kiwih/hackster-programmer/hardware/unsw-cse-hackster-cc-by-sa-4.0/cse-hackster-feb-2026.pdf

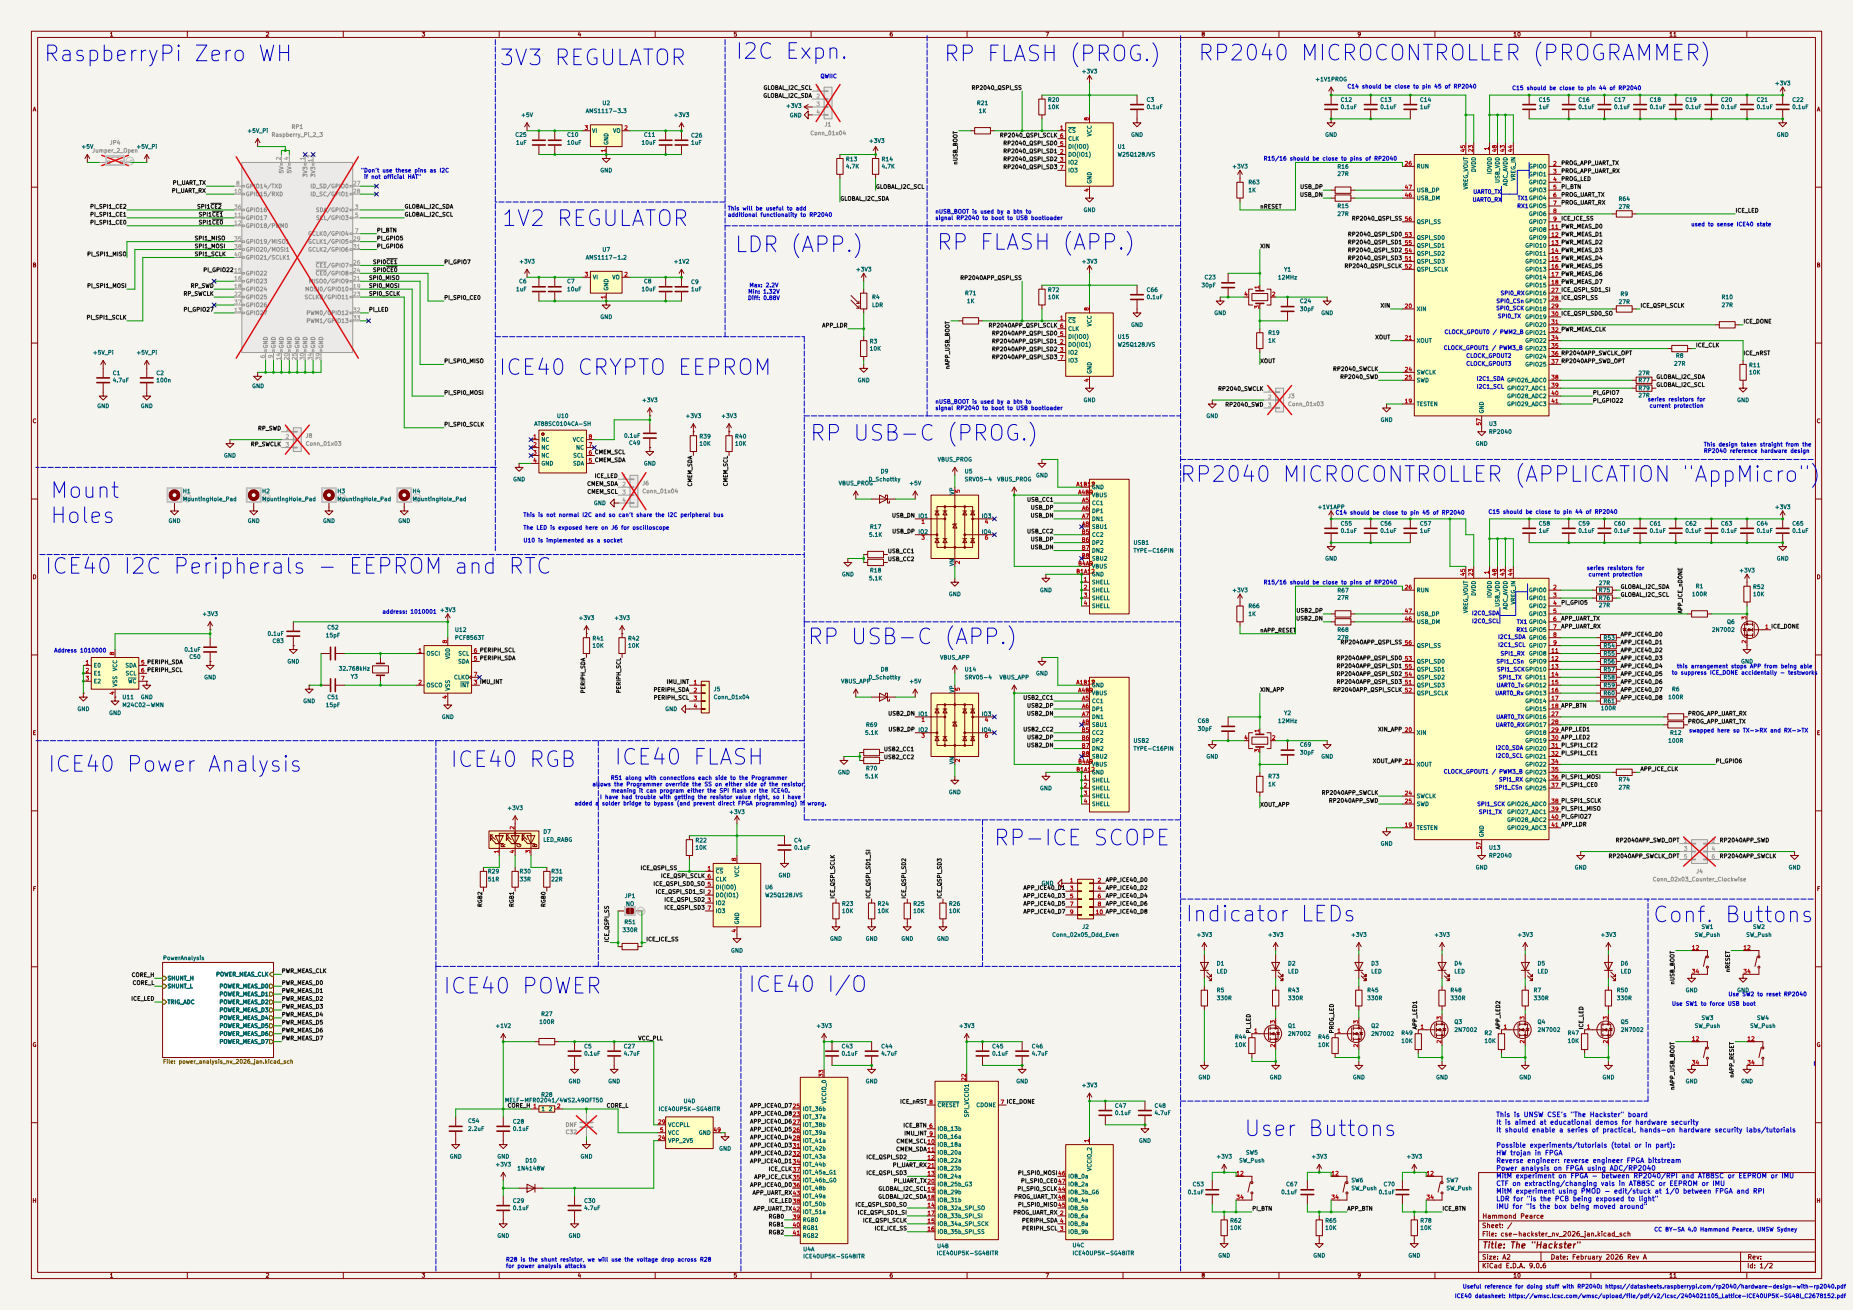
[picture p1: page 1]

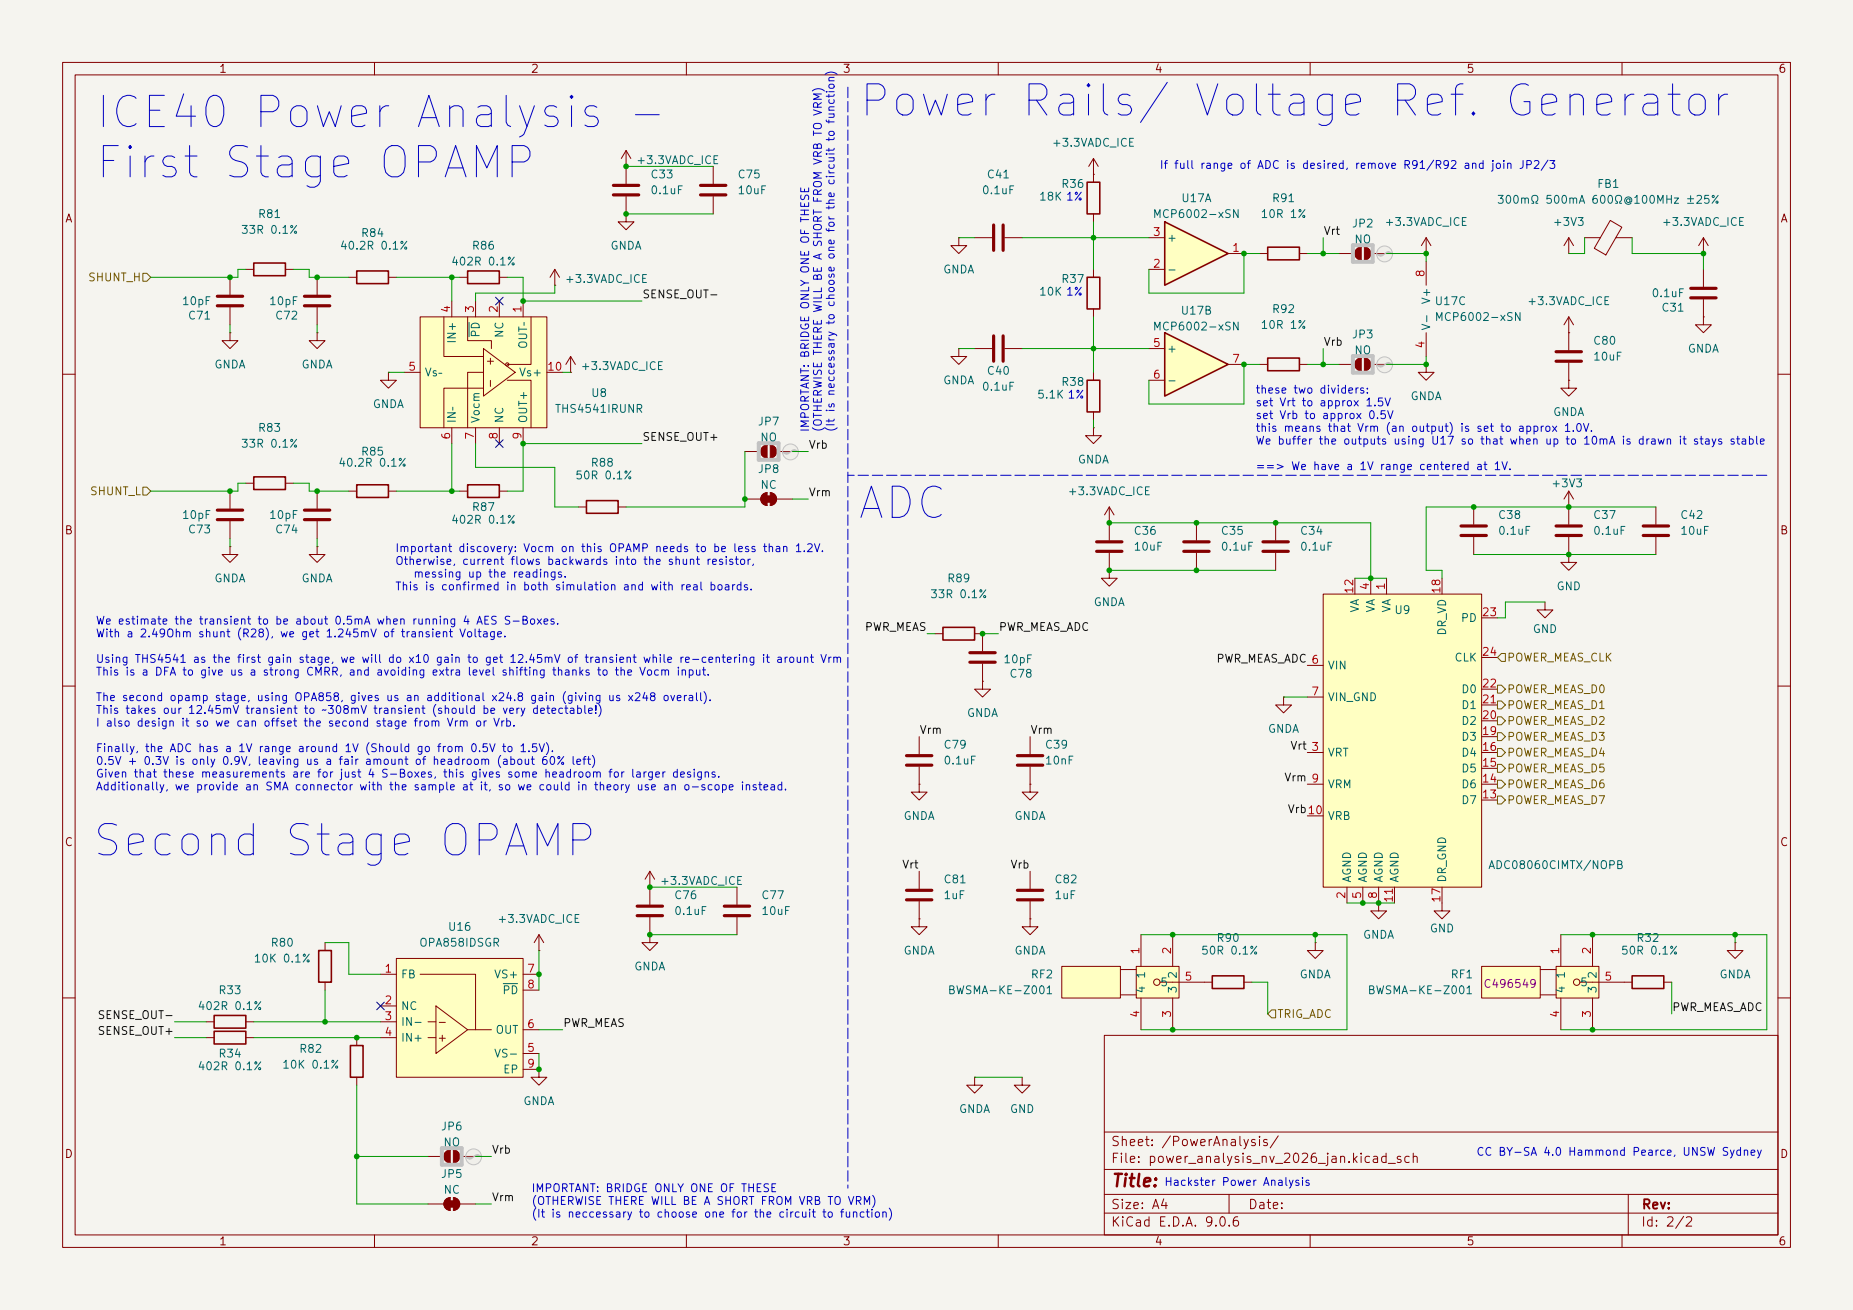
[picture p2: page 2]
