kiwih/hackster-programmer/hardware/unsw-cse-hackster-cc-by-sa-4.0/cse-hackster-gerber-preview-combined-layers-feb-2026.pdf

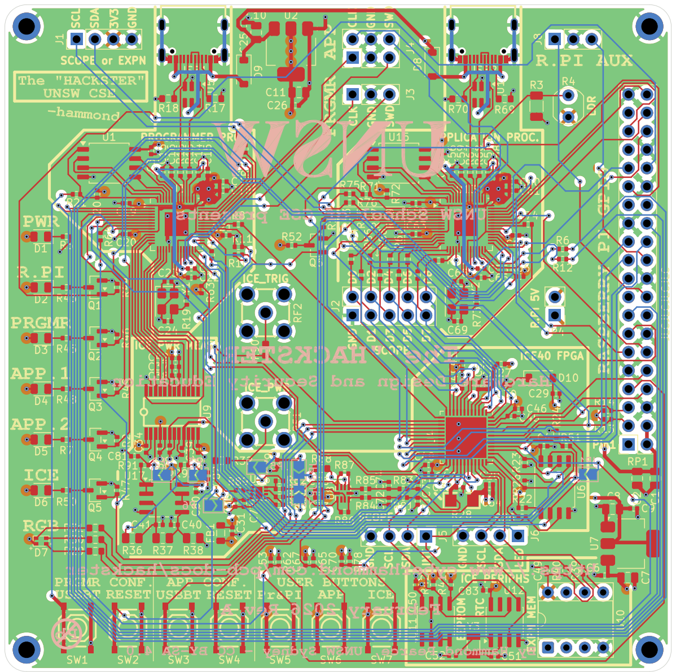
[picture p3: page 1]
