kiwih/hackster-programmer/hardware/unsw-cse-hackster-cc-by-sa-4.0/cse-hackster-gerber-preview-seperate-layers-feb-2026.pdf

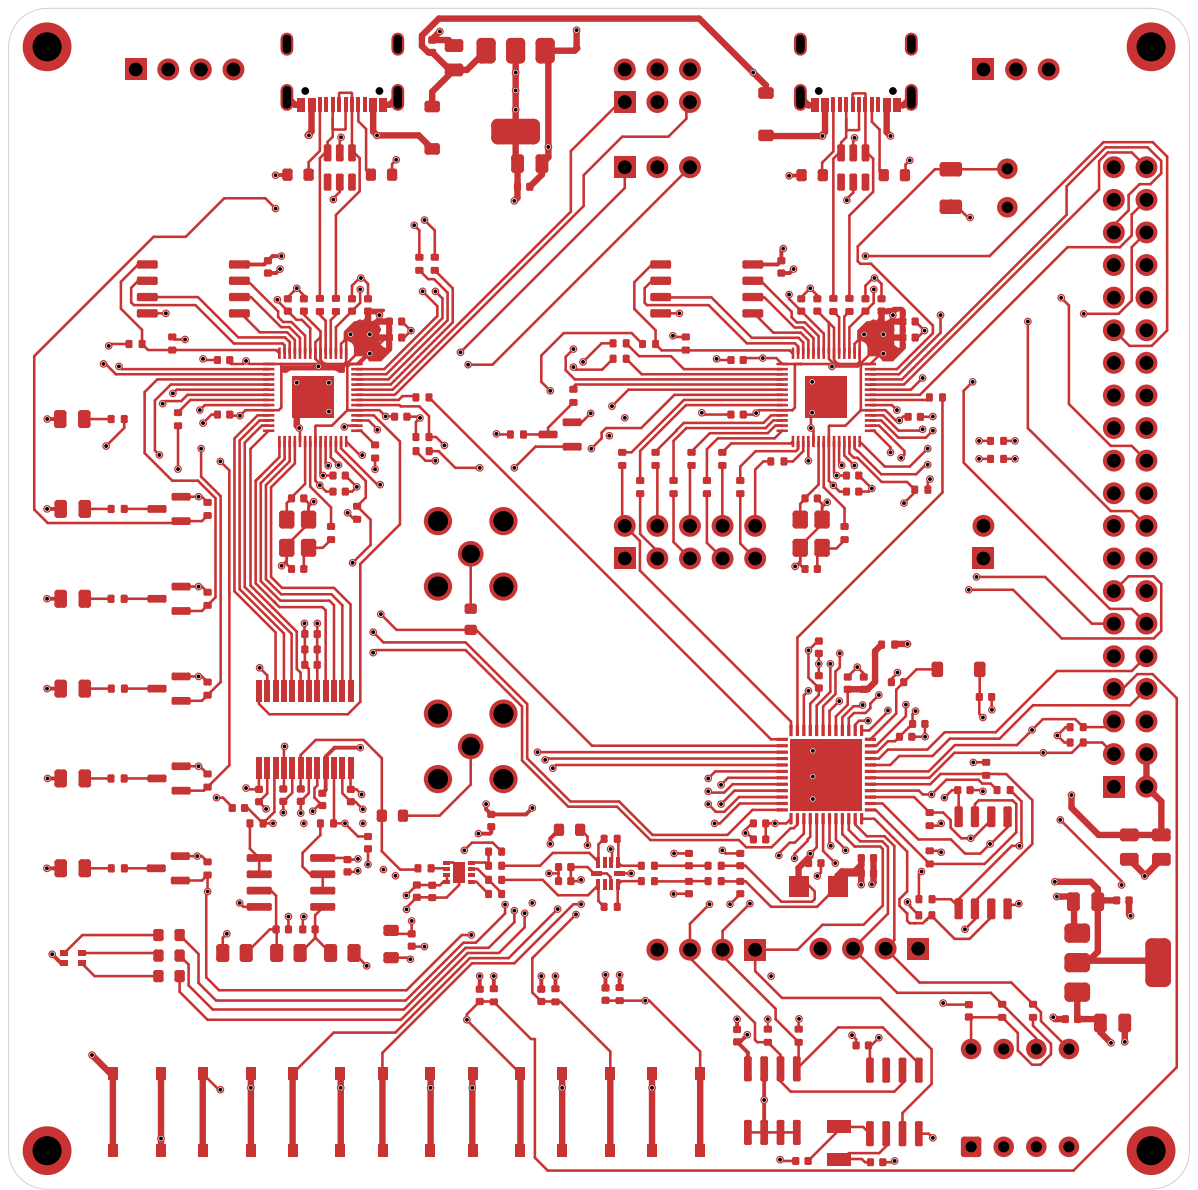
[picture p4: page 1]

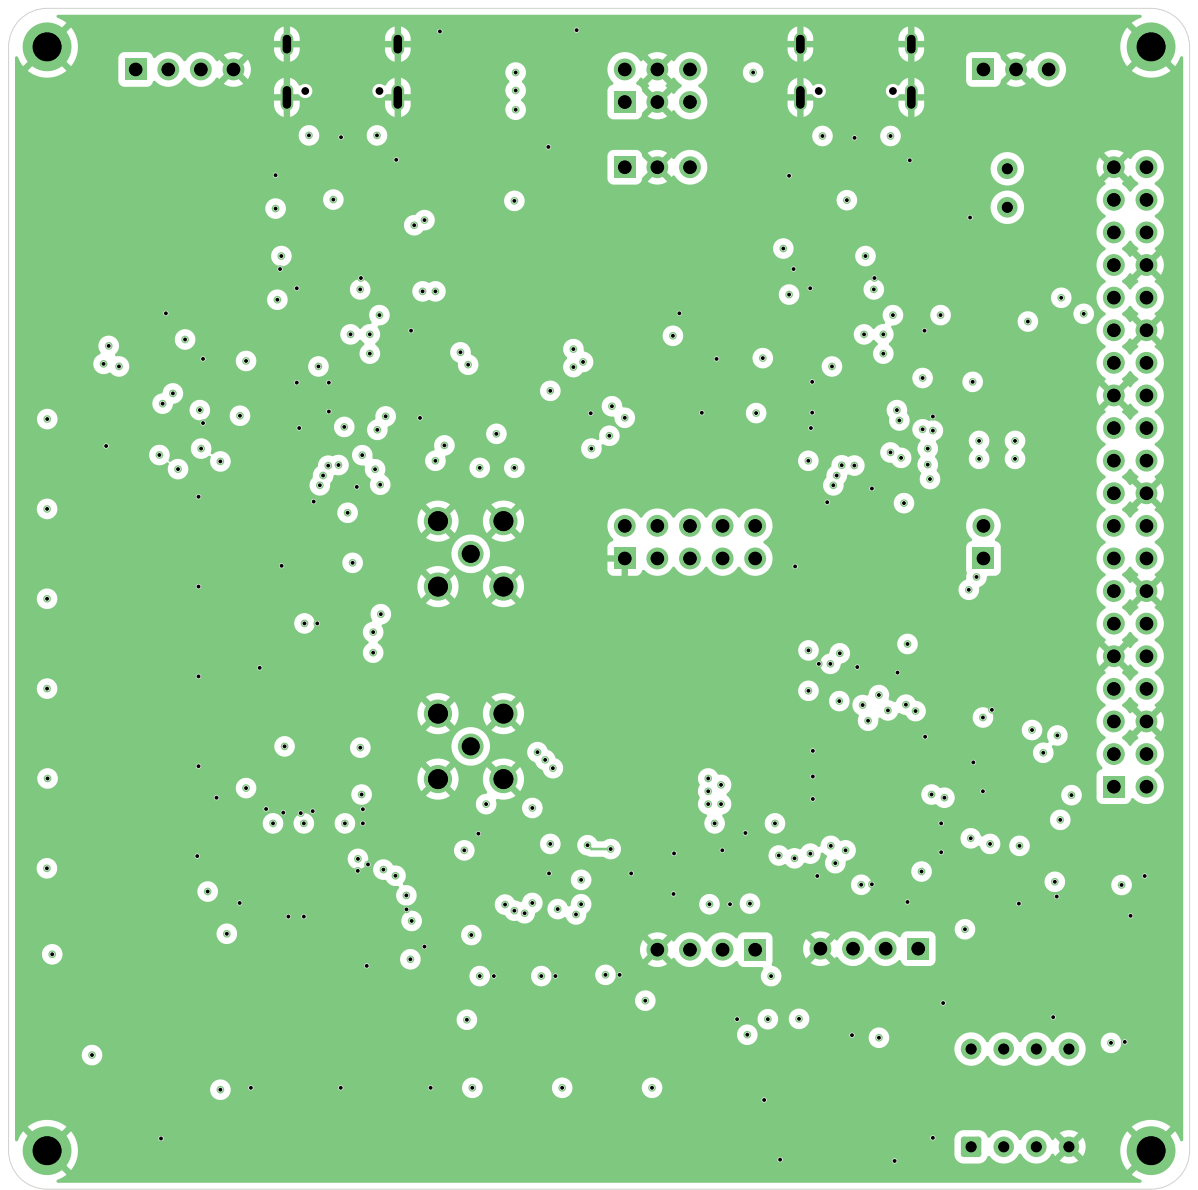
[picture p5: page 2]

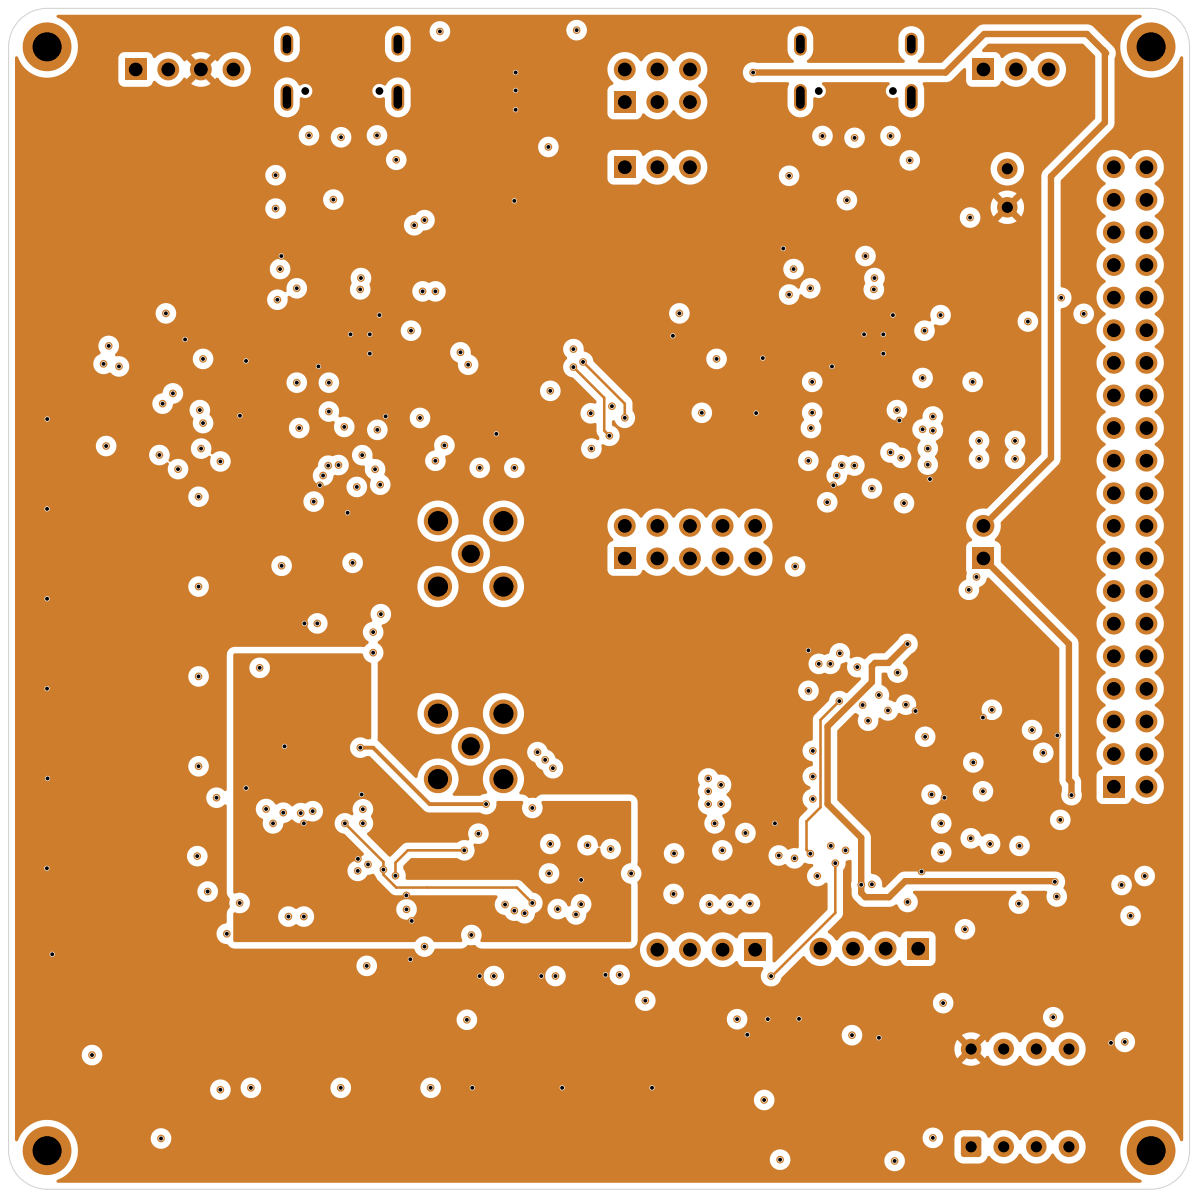
[picture p6: page 3]

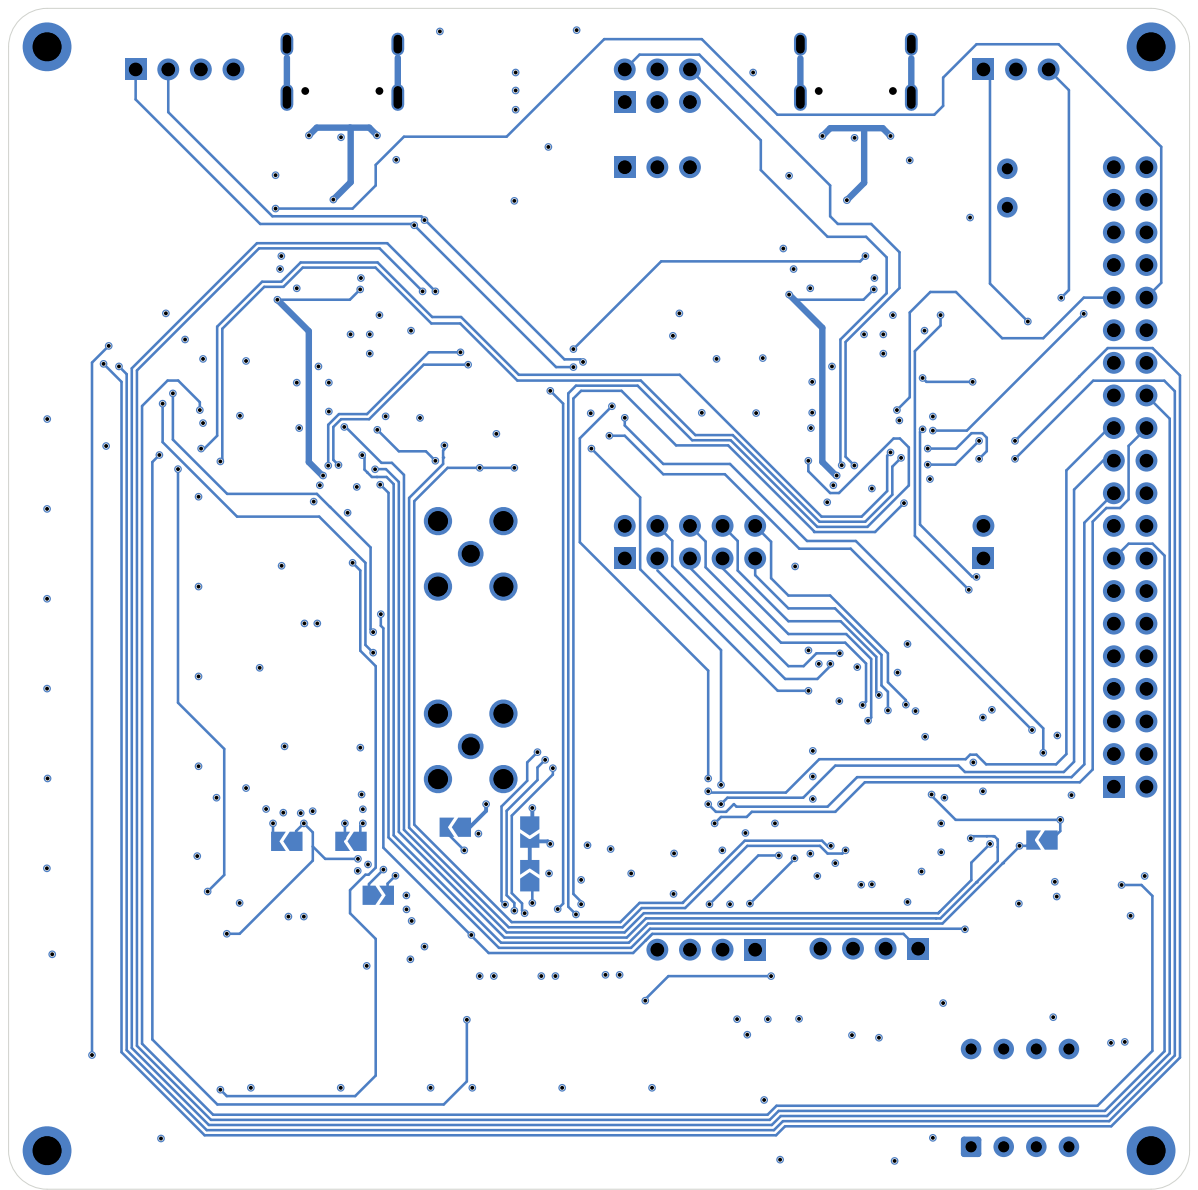
[picture p7: page 4]

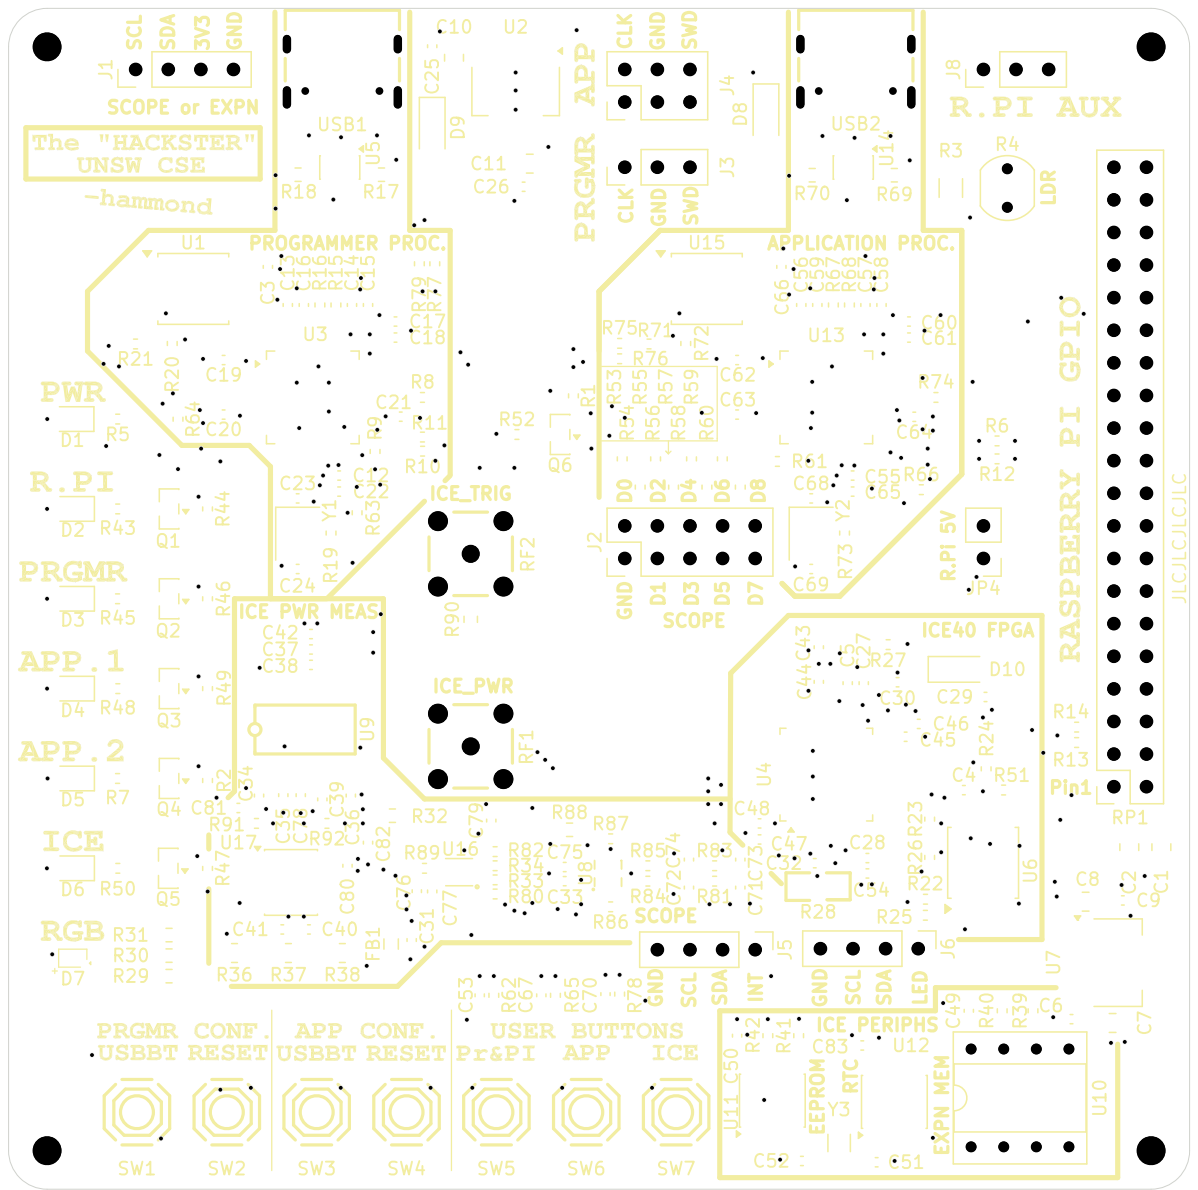
[picture p8: page 5]

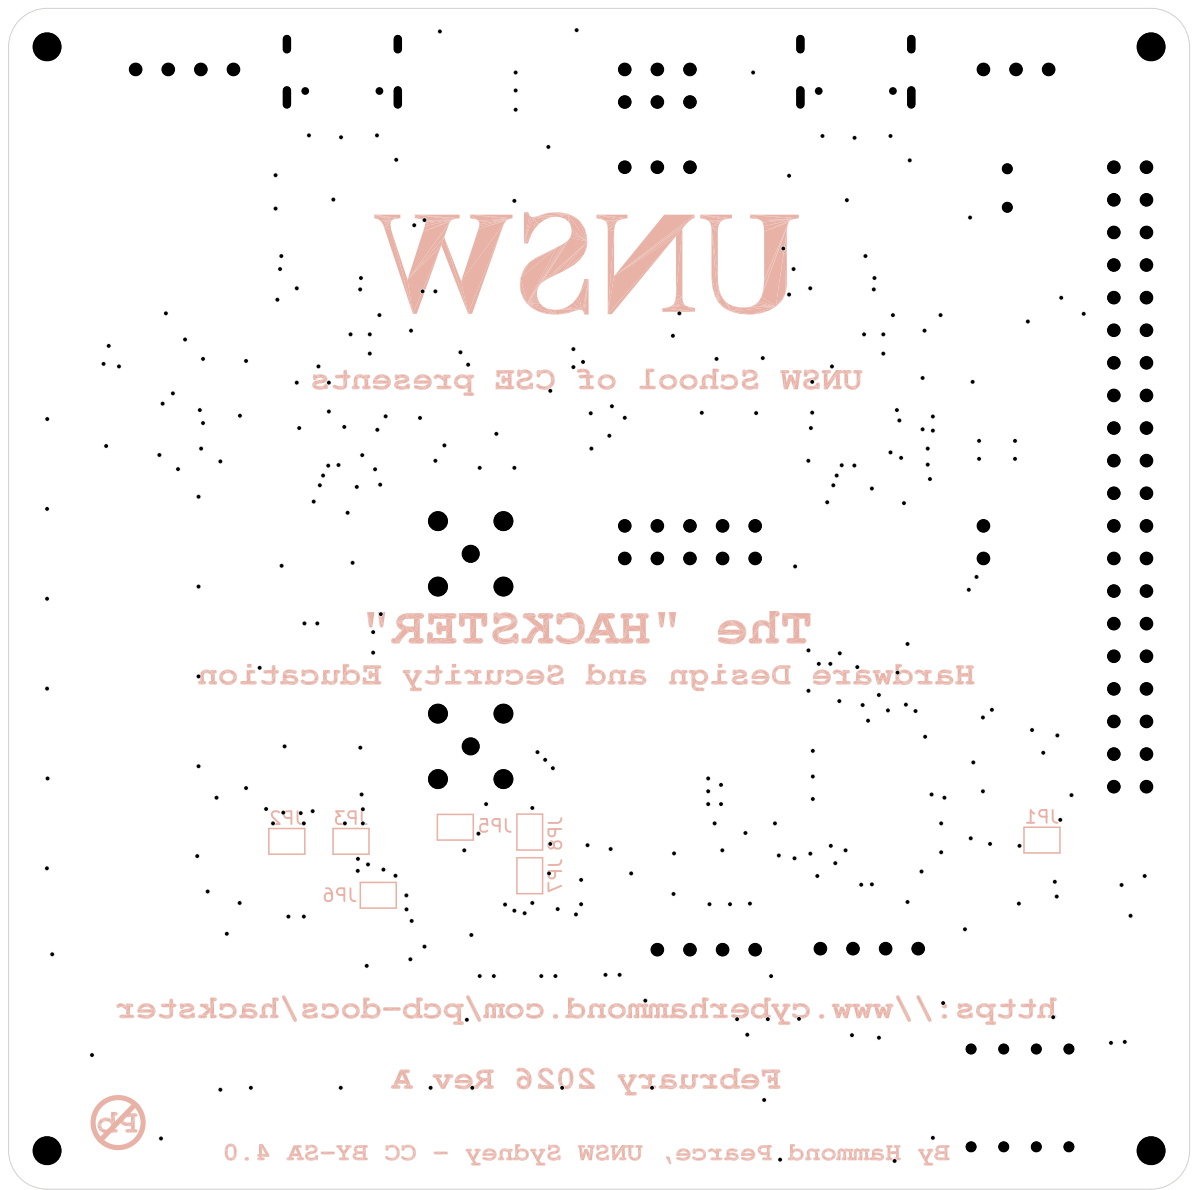
[picture p9: page 6]

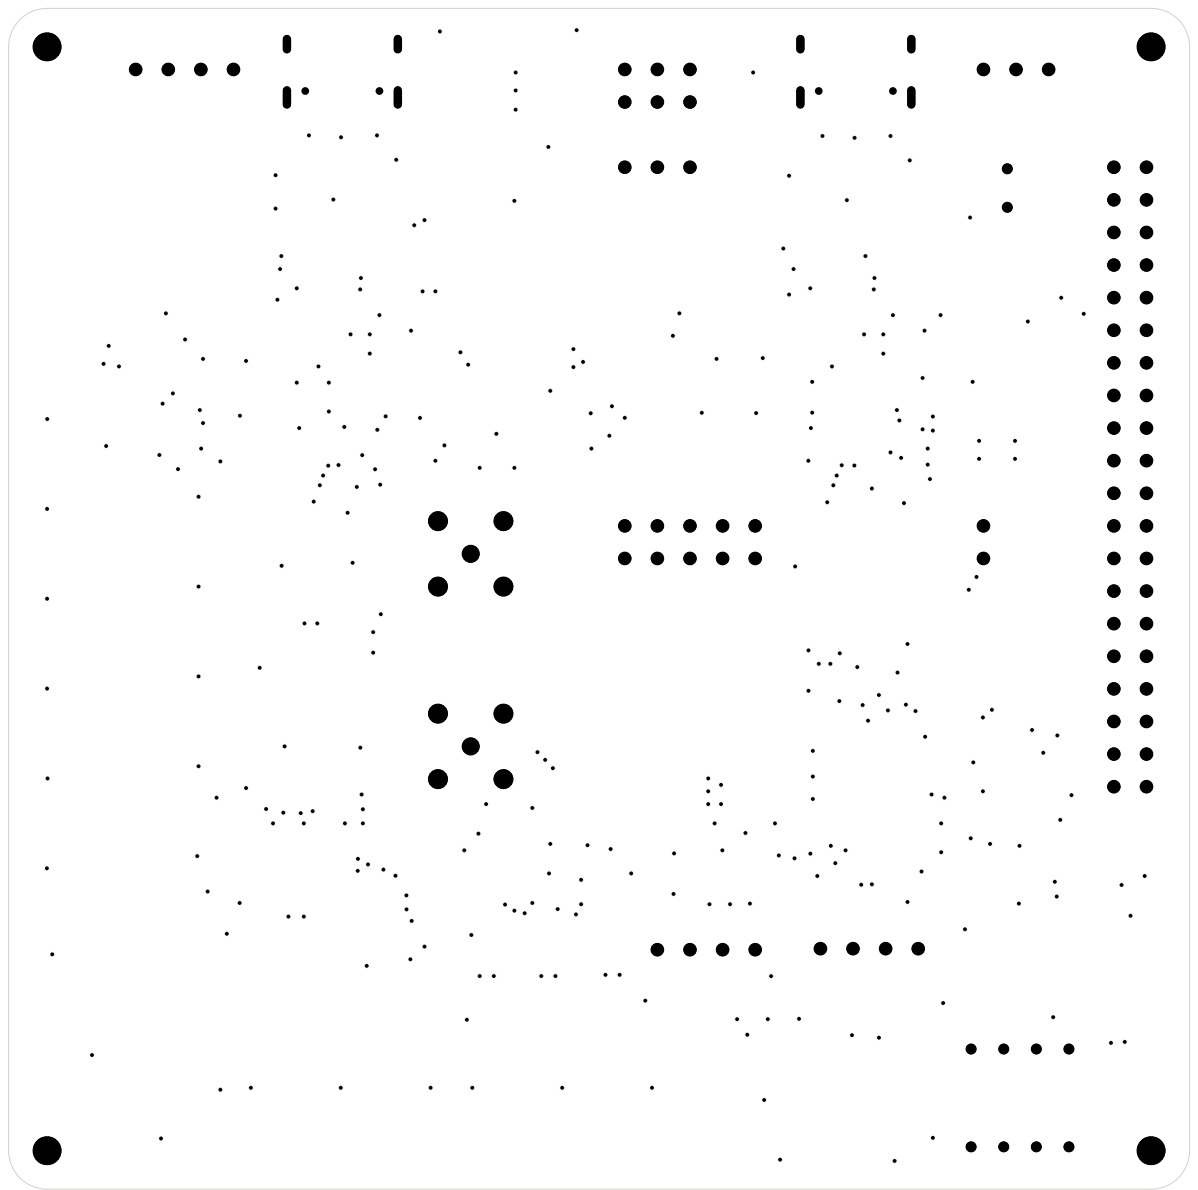
[picture p10: page 7]
