kiwih/hackster-programmer/examples/spi_simple/spi_simple.py

import machine
import time

ice_done = machine.Pin(3, machine.Pin.IN)

SCK = machine.Pin(6, machine.Pin.OUT)
RST_N = machine.Pin(7, machine.Pin.OUT)
MOSI = machine.Pin(8, machine.Pin.OUT)
MISO = machine.Pin(9, machine.Pin.IN)
NORM_CS_N = machine.Pin(10, machine.Pin.OUT)

SCK.value(0)
RST_N.value(1)
NORM_CS_N.value(1)

spi = machine.SoftSPI(baudrate=50000, polarity=0, phase=0, bits=8, firstbit=machine.SPI.MSB, sck=SCK, mosi=MOSI, miso=MISO)

# reset SPI
RST_N.value(0)
SCK.value(1)
SCK.value(0)
RST_N.value(1)
SCK.value(1)
SCK.value(0)

while True:
    txdata = bytearray([0x08])
    rxdata = bytearray(1)

    # engage the input SPI and exchange bytes
    NORM_CS_N.value(0)
    spi.write_readinto(txdata, rxdata)
    NORM_CS_N.value(1)
    
    time.sleep(0.0001) #put a very short delay to make it visible on the scope
    SCK.value(1) #run one clock cycle with NORM_CS_N set high to update the capture reg
    SCK.value(0)
    
    print(rxdata)
    time.sleep(0.1)
