kiwih/hackster-programmer/(commit log)

2025-01-09 Updated passthrough and tested on new board - it works
2025-01-13 rename sample project dir
2025-01-22 Working on i2c registers example
2025-01-22 Something wrong with TX states, gonna try rewriting as mealy
    [i2c_simple_slave.v, i2c_simple_slave_tb.v]
2025-01-22 It doesn't work but i think this approach is better, something wrong with an extra clock cycle of i2c_buf_cnt_en
    [i2c_simple_slave.v, i2c_simple_slave_tb.v]
2025-01-23 Working with soft I2C, think a HW PCB issue
    [i2c_simple_slave.v]
2025-01-29 Add blinky LED PUF
2025-01-30 Add author info and rename i2c files
2025-01-31 Add SPI simple example and DES with scan chain
2025-02-01 Finish des with scan chain example
2025-02-01 Improvements to makefile to support synthesis-time definition insertion
2025-02-04 rename spi example and add spi_des (no scan chain) as example
2025-02-05 Fix bug with AES, needed a NOT on the encrypt_ndecrypt signal. Works in sim and synth
    [aes_sbox.v, spi_aes_top.v]
2025-02-07 I2C fixes on Feb 2025 version. Updated firmware uf2 record.
    [i2c_simple_slave.v, spi_simple.py]
2025-02-07 Add power_aes_no_io demo for showing power capture over AES
2025-02-12 first fully correct DPA
    [top.v]
2025-02-12 Stop tracking power data
2025-02-12 Stop tracking power data in sbox example
2025-02-27 Verify firmware works for rgbdemo and power_aes_4sbox, have to increase noise for power demo
    [top.v]
2025-03-08 add i2c master, it supports read&write one byte
2025-03-11 Add missing lfsr.py file
    [lfsr.py]
2025-03-16 clean up unnecessary files in i2c_register directory, move some to i2c_trojan
2025-03-17 changed i2c ports to id=0 for consistency
2025-03-17 step 2 starter code includes reading from ICE button
2025-03-17 verified step 3 on new board
2025-04-05 Fix constraints for RGB LEDs
    Looking at the schematic, pins 39, 40, and 41 are connected to RGB0,
    RGB1 and RGB2 respectively, which are then connected to the blue, green
    and red LEDs respectively within the RGB LED. This fixes all the
    constraints in this repository to respect that.
    `SB_RGBA_DRV` seems to ignore what you connect its outputs to and
    output to the `LED*` pins no matter what, so it needs to have its
    arguments rearranged as well.
    [rgb_demo.v]
2025-04-09 Fix a bunch of issues in i2c_master and i2c_simple_slave
    I debugged and fixed a lot of issues in these while working on lab 3 -
    there are still some TODOs but I want other people to be able to use
    this already.
    [i2c_master.v, i2c_simple_slave.v]
2025-04-09 Don't add an extra cycle of delay to the FSM
    This was the root cause of the issue where the master would continue to
    hold SDA low after an ACK, preventing a start condition from being
    generated.
    [i2c_master.v]
2025-06-16 Improve ring oscillator to be more different between boards by having 70 not gates
    [ring_oscillator.v]
2026-01-08 Attempt improvements to power_aes_no_io to perform a CPA
2026-01-11 Pin versions in the Dockerfile
2026-01-22 increase samples, aids CPA
2026-02-11 Tidying power aes project
2026-02-12 Scan chain implementation of AES (1 clock cycle per round)
2026-02-23 Making new version of power_aes_no_io which is actually 4 cycles, first step was to move the shiftrow before sboxes always
2026-02-23 New 4cycle version not quite finished yet, issue with intermediate values being overwritten
    [aes_core_static_multicycle_4sbox_128.v, aes_core_tb.v, aes_mixcolumn.v]
2026-03-09 Remove commented out code from top.v in AES power example
2026-04-01 Move RTC micropython to correct folder and test it
    [rtc.micropython.py]
2026-04-03 Tested i2c_registers and updated associated testbench
2026-04-03 Fix an issue in testbench for i2c_simple_slave
    [i2c_simple_slave.v, i2c_simple_slave_tb.v]
2026-04-04 Minor changes to i2c_master to better support multibyte transactions of indeterminate lengths
2026-04-05 Update i2c_master to a better version, more suited for various clock stretches
